kaligari/seba-1/docs/bus-debugger/Logisim schematic.jpg

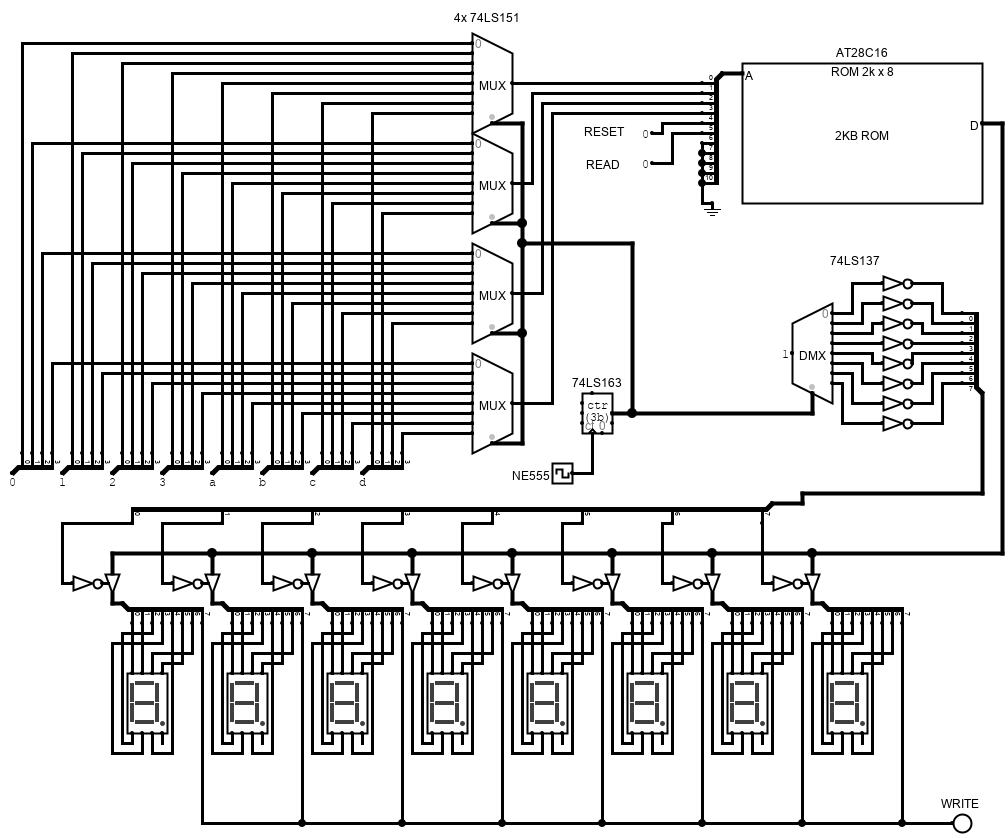
docs/bus-debugger/Logisim schematic.jpg
