kaligari/seba-1/docs/bus-debugger/SEBA-1 Bus Debugger schematic.pdf

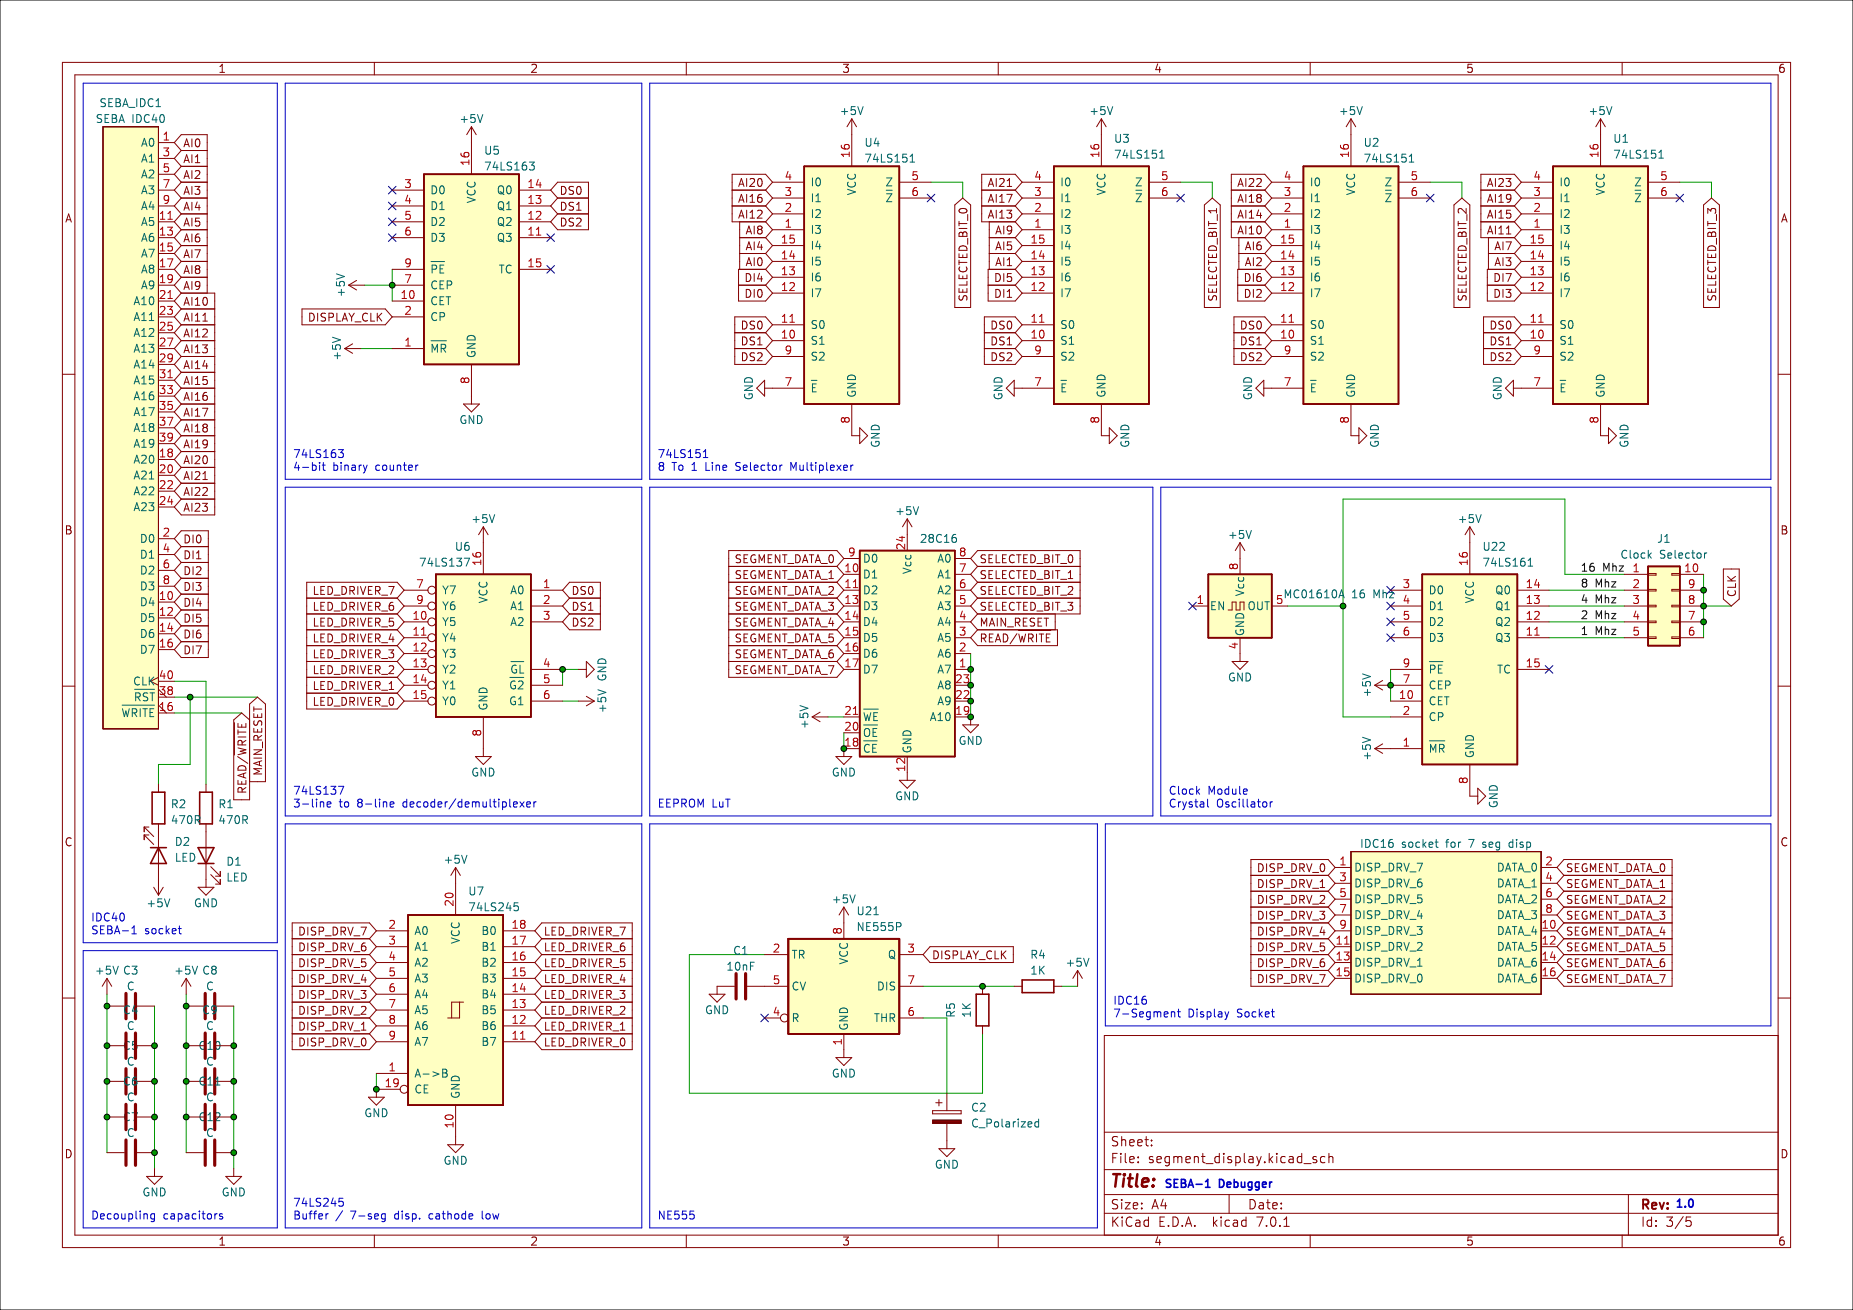
[picture p2: page 1]
