kaligari/seba-1/docs/65C22 VIA/SEBA-1 65C22 VIA schematic.pdf

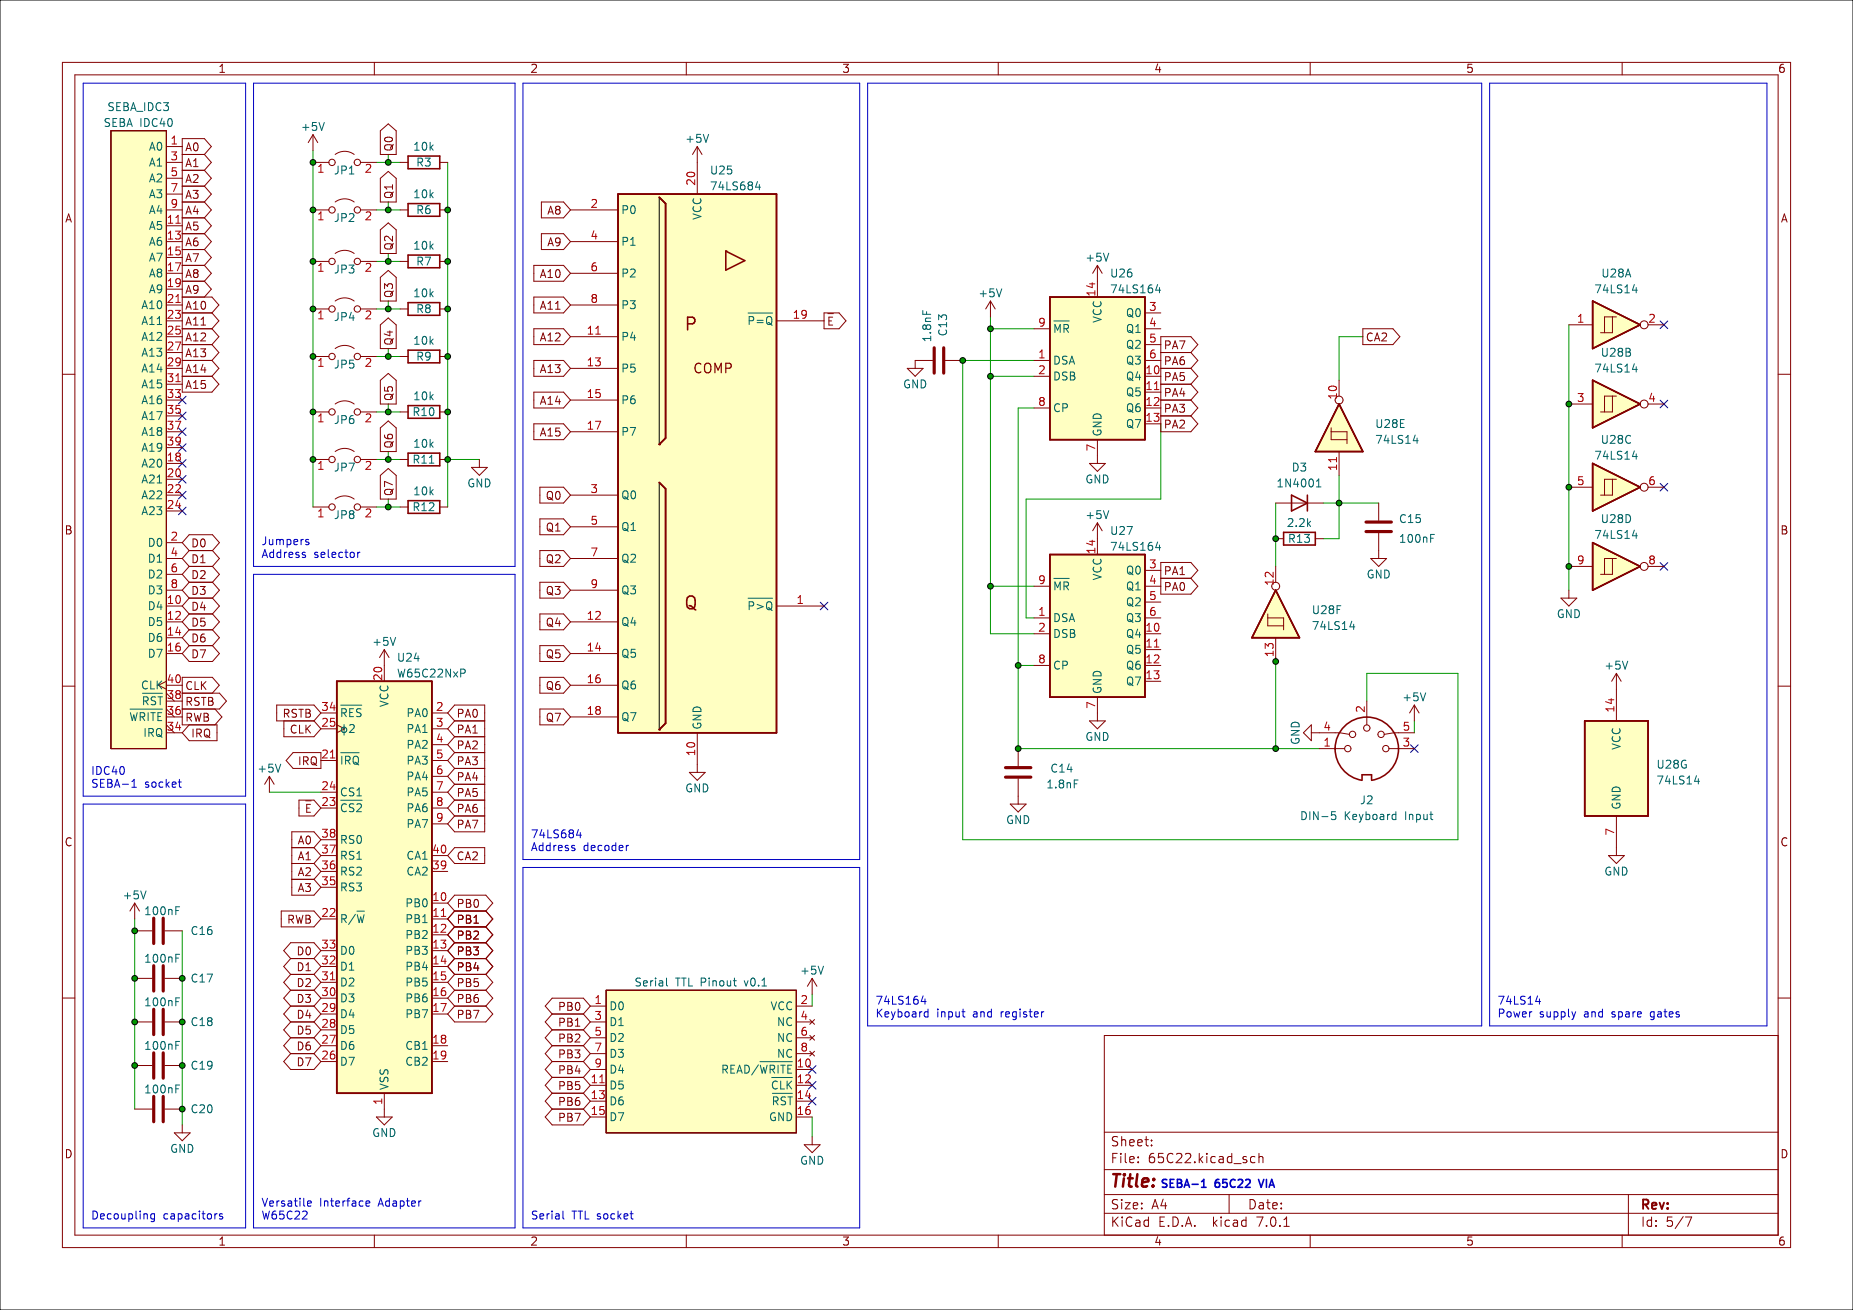
[picture p3: page 1]
