kaligari/seba-1/docs/65C22 VIA/SEBA-1 Sampler schematic.pdf

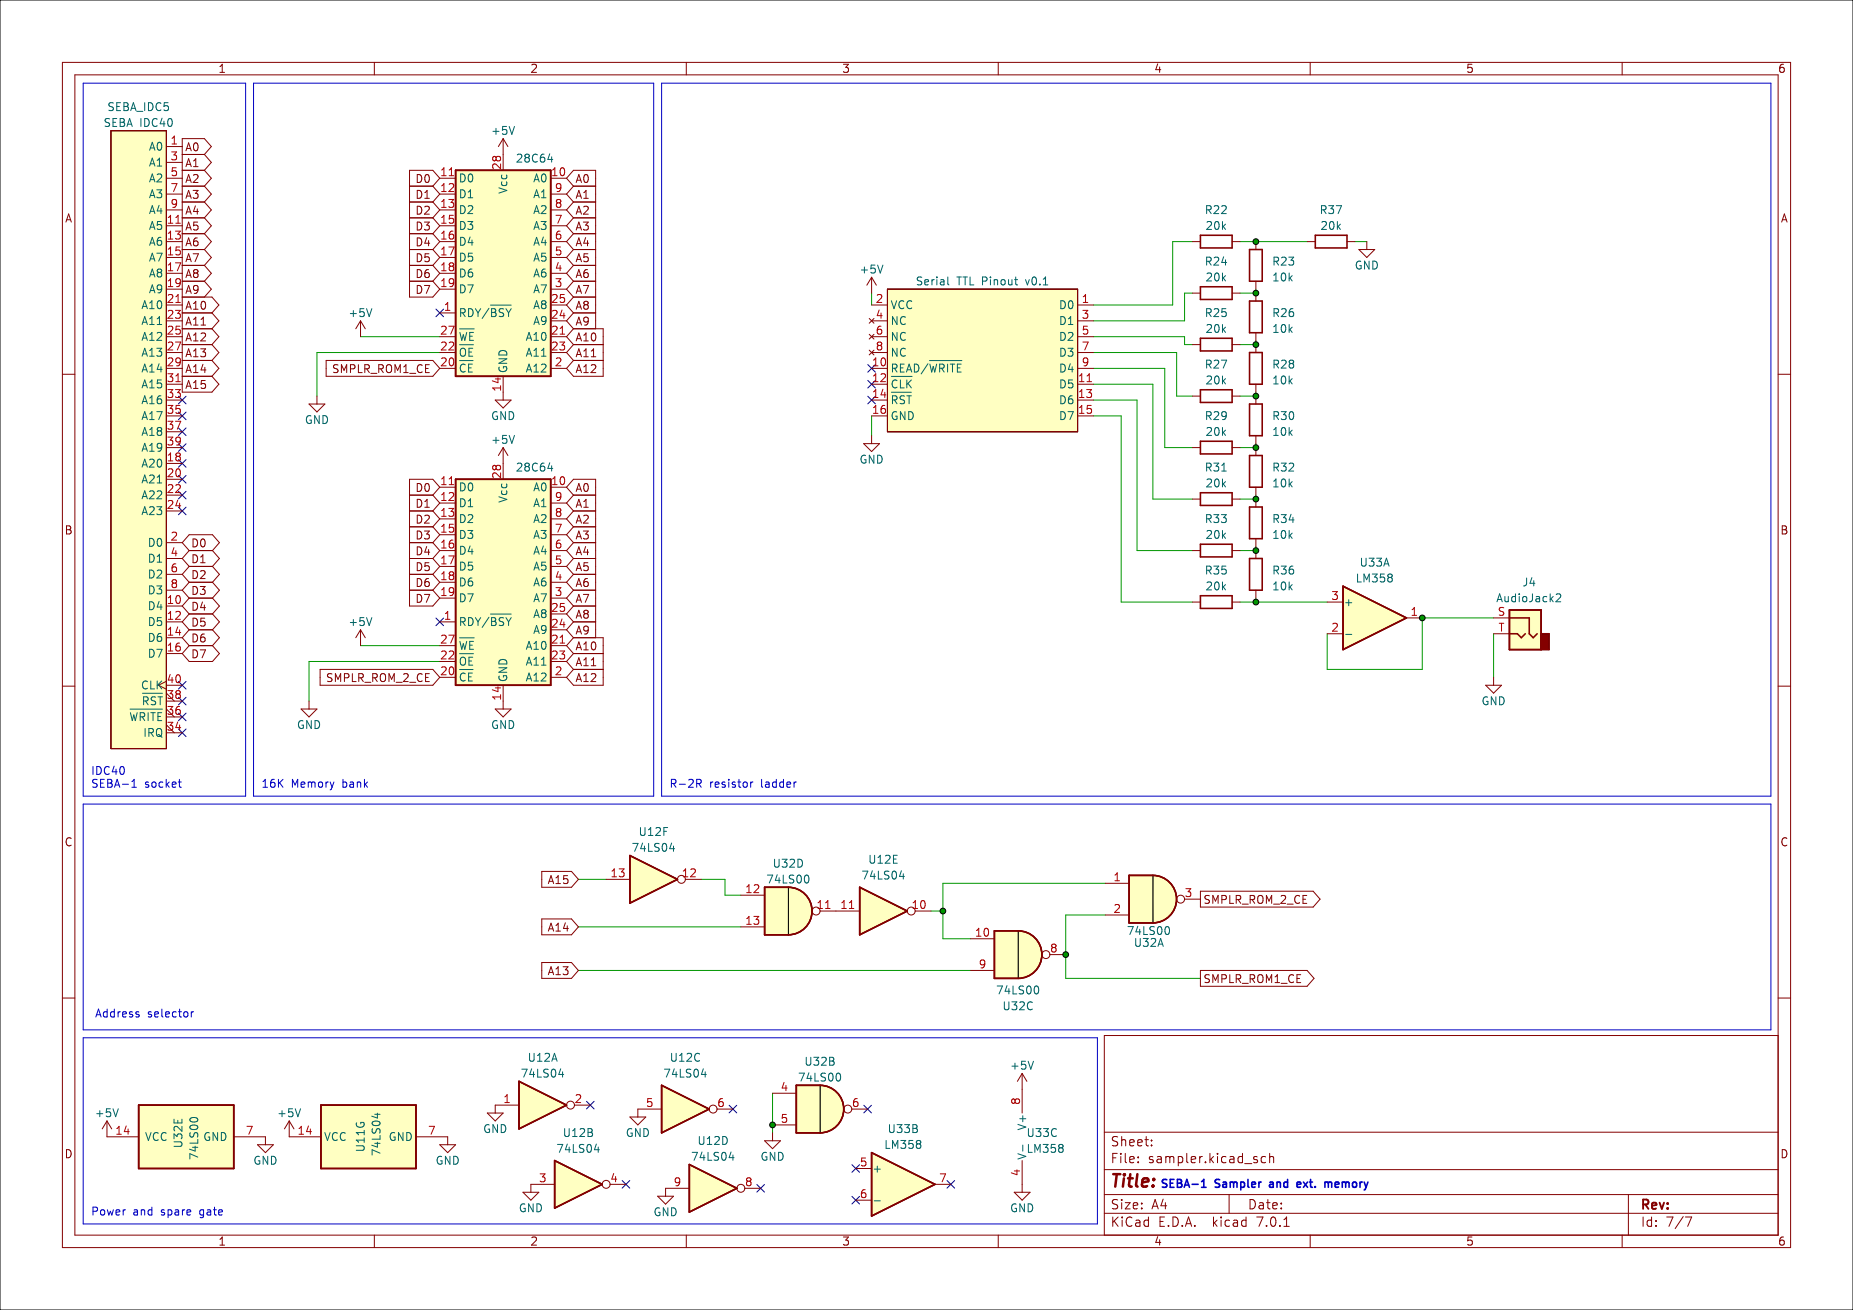
[picture p4: page 1]
