kaligari/seba-1/docs/cpu/SEBA-1 65C02 CPU schematic.pdf

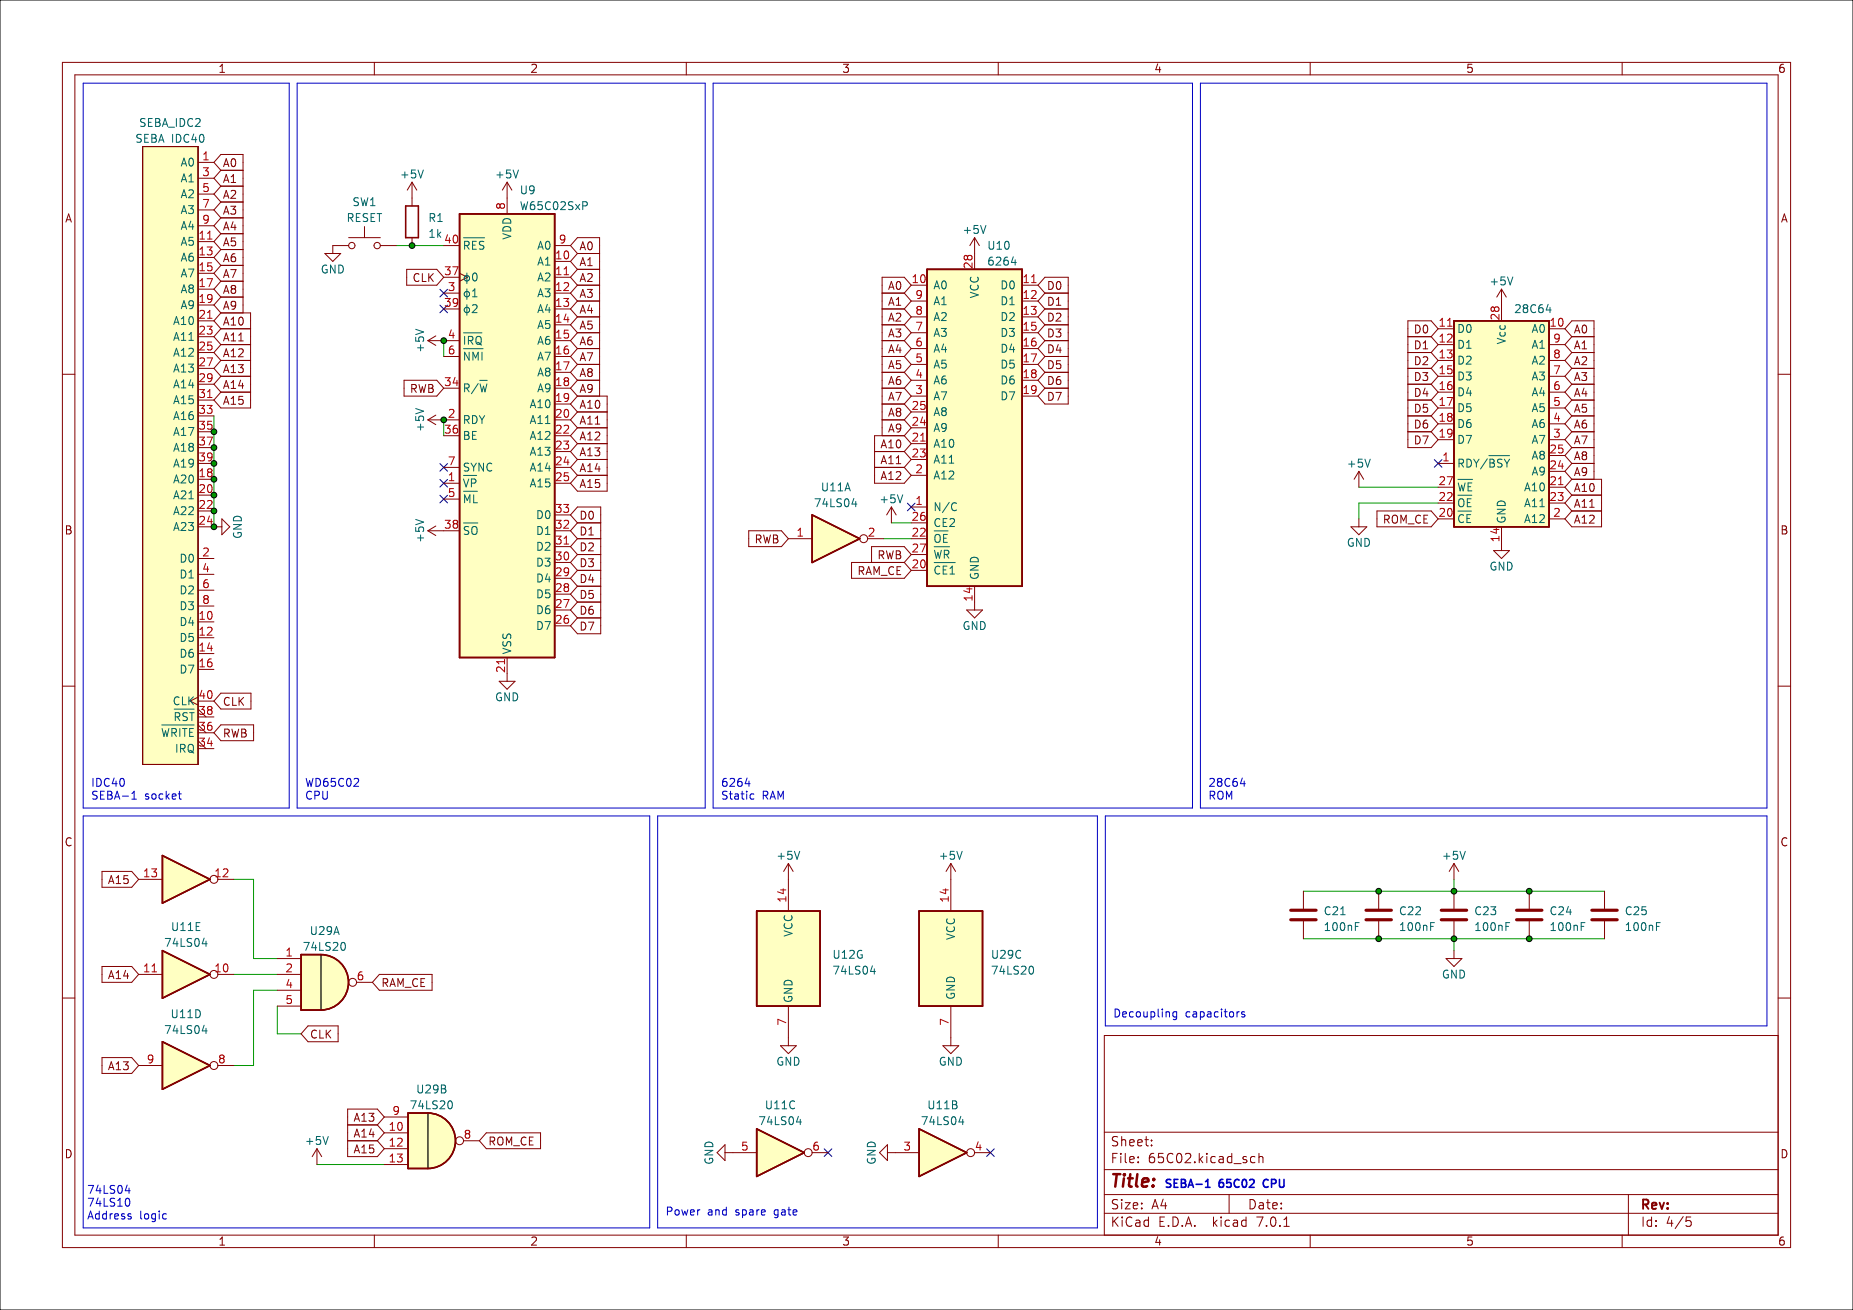
[picture p5: page 1]
