kaligari/seba-1/(list of files, drawings)

Other design files:
docs/bus-debugger/BusDebugger.circ
