kaligari/seba-1/(threads)

Thread 2 (2025-06-21):

bus-debugger EEPROM code

vslinuxdotnet, 2025-06-21:
Hello,

Congrats for the project, i also build some project like you in the past but more compact.
But missed one thing that you build: the bus-debugger... and i try some projects in GALS, and failed, them build it in Arduino Atmega, but it's not perfect.
I will like to build yours, but seams that you don't provide the src code or hex for the 28c16 EEPROM.
its available ?

Thanks

vslinuxdotnet, 2025-06-27:
> Did you check the secondary branch? There is a branch labeled CC65 that has more information

Yes, the CC65 is a assembly compiler for 6502, the code  is for CPU.
I refer missing the src code from EEPROM 28c16 to drive the 7 segment displays.

vslinuxdotnet, 2025-06-27:
I found one code in BenEater github:
https://github.com/beneater/eeprom-programmer/blob/master/multiplexed-display/multiplexed-display.ino
seams to be that  correct ?

vslinuxdotnet, 2025-07-05:
Anyone can test, is the eeprom content is ok:
https://github.com/vslinuxdotnet/mixedcode/blob/main/28C16_7segment_mapper.bin

I get E chars only.
