kaligari/seba-1/(commit log)

2025-05-30 Initial commit: Bus Debugger
    [BusDebugger.circ]
2025-06-13 Add 65C02 CPU schematic
2025-06-15 Fix 65C02 CPU schematic
2025-06-19 Add BIOS and WOZMON source files, configuration, and build setup
    [bios.cfg]
2025-06-29 Update BIOS configuration and add keyboard, LCD, and sampler source files; enhance build process with symbol file generation
    [bios.cfg]
2025-06-29 Refactor keyboard, LCD, and sampler
2025-07-28 Add SEBA-1 Sampler schematic PDF file
2025-07-28 Update sample table comments for clarity and rename delay function
2025-07-28 Add README for SEBA-1 Sampler Module detailing usage, hardware, and sample preparation
2025-07-28 SEBA-1 Sampler
2025-07-30 Update sampler.s to correct PORTB assignment and adjust delay timing
2025-08-13 Add 65C22 VIA schematic
